boringtaskai/splitflap/3d/flapnew.png

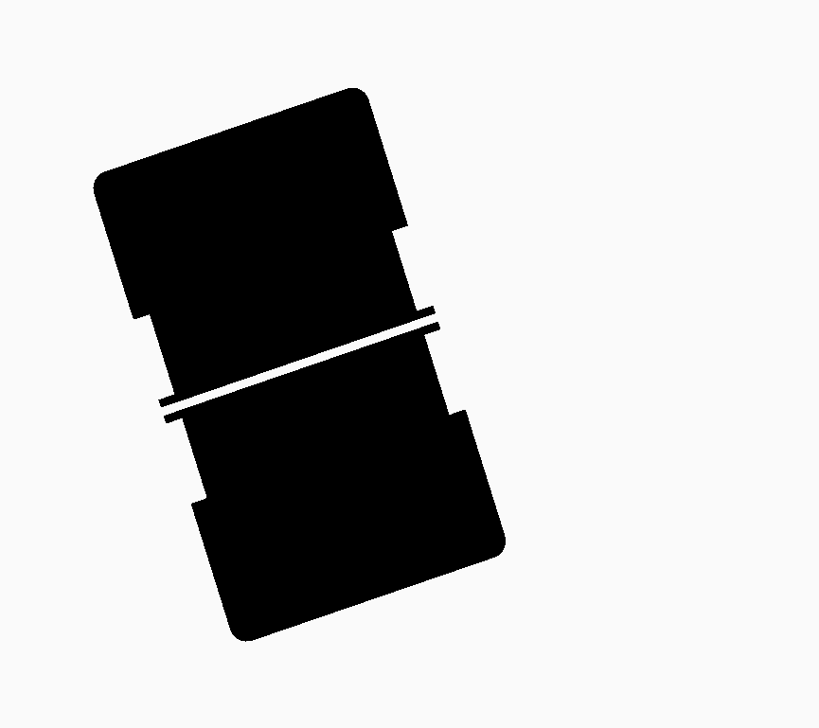
3d/flapnew.png
