boringtaskai/splitflap/3d/spoolnew.png

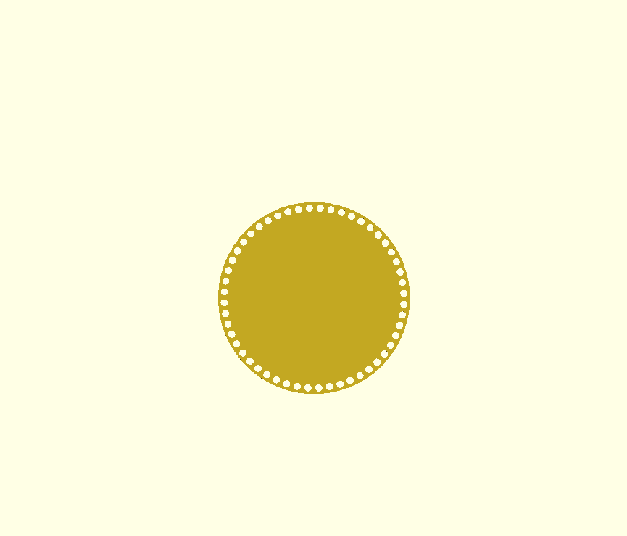
3d/spoolnew.png
