boringtaskai/splitflap/3d/spool_60_12_test.stl

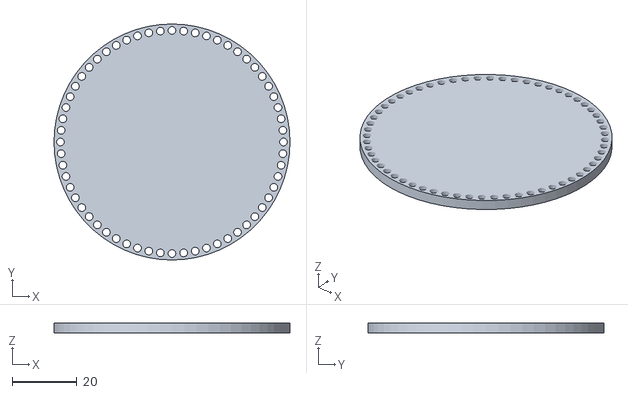
[picture p3: CAD file, 2026-01-23]
3d/spool_60_12_test.stl
72.8 x 72.8 x 3.00
