boringtaskai/splitflap/3d/spool_52_12_test.stl

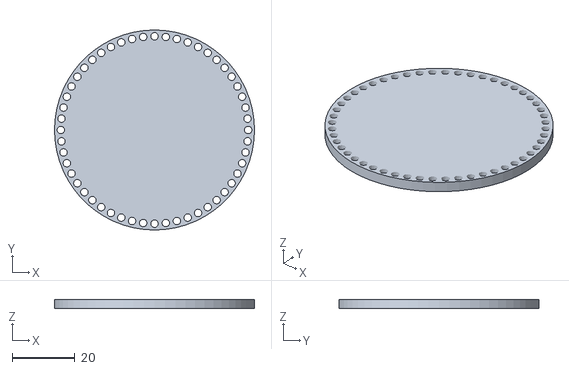
[picture p4: CAD file, 2026-01-23]
3d/spool_52_12_test.stl
63.6 x 63.6 x 3.00
