boringtaskai/splitflap/3d/spool_60_11_test.stl

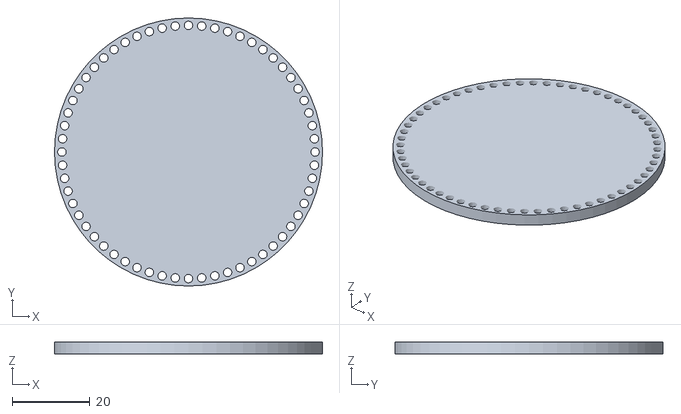
[picture p5: CAD file, 2026-01-23]
3d/spool_60_11_test.stl
68.7 x 68.7 x 3.00
