boringtaskai/splitflap/3d/frontpanel_1x2.3mf

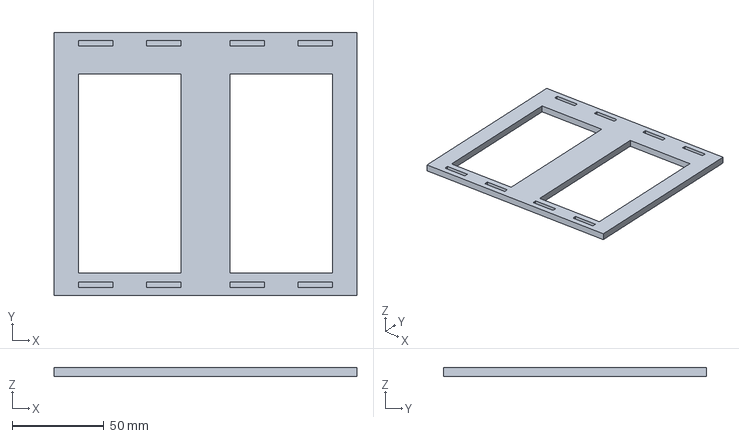
[picture p6: CAD file, 2026-01-19]
3d/frontpanel_1x2.3mf
165.2 x 143.5 x 5.00 mm
