boringtaskai/splitflap/3d/flap_characters.scad

//the original " ABCDEFGHIJKLMNOPQRSTUVWXYZg0123456789r.?-$'#yp,!@&w";

character_list = " ABCDEFGHIJKLMNOPQRSTUVWXYZ0123456789☁️
🌧️☀gr°$:♥💔😂😭👍👎🔴";
function get_character_list() = character_list;
