boringtaskai/splitflap/(list of files, cad)

Other CAD files:
3d/flap_custom.scad
3d/flap_dimensions.scad
3d/font_generator_custom.scad
3d/font_generator_jig.scad
3d/splitflap_custom.scad
3d/frontpanel_1x2.stl
