boringtaskai/splitflap/(commit log)

2025-11-21 heavily add feature on script to generate image for flap
    [combined_front_panel_custom.scad, flap.scad, flap_characters.scad, flap_container_single_flap.scad, font_generator.scad, newsplitflapdrumandframe.scad, splitflap_custom.scad]
2025-11-21 add font custom font generator
    [font_generator_custom.scad, font_generator_jig.scad]
2026-01-19 add http_server_task for API, and also other custom flap
    [flap_characters.scad, flap_custom.scad, flap_fonts.scad, font_generator_custom.scad, frontpanel_1x2.3mf, frontpanel_1x2.stl, splitflap_custom.scad, spool_52_12_test.stl]
2026-01-23 add http server task
    [configuration.h, flap_characters.scad]
2026-01-23 add http server and also custom font generator and flaps
    [combined_front_panel_custom.scad, configuration.h, flap.scad, flap_characters.scad, flap_container_single_flap.scad, flap_custom.scad, flap_dimensions.scad, flap_fonts.scad]
